KabirEsha/VariableDCSupply/photo_2025-03-07_00-40-33.jpg

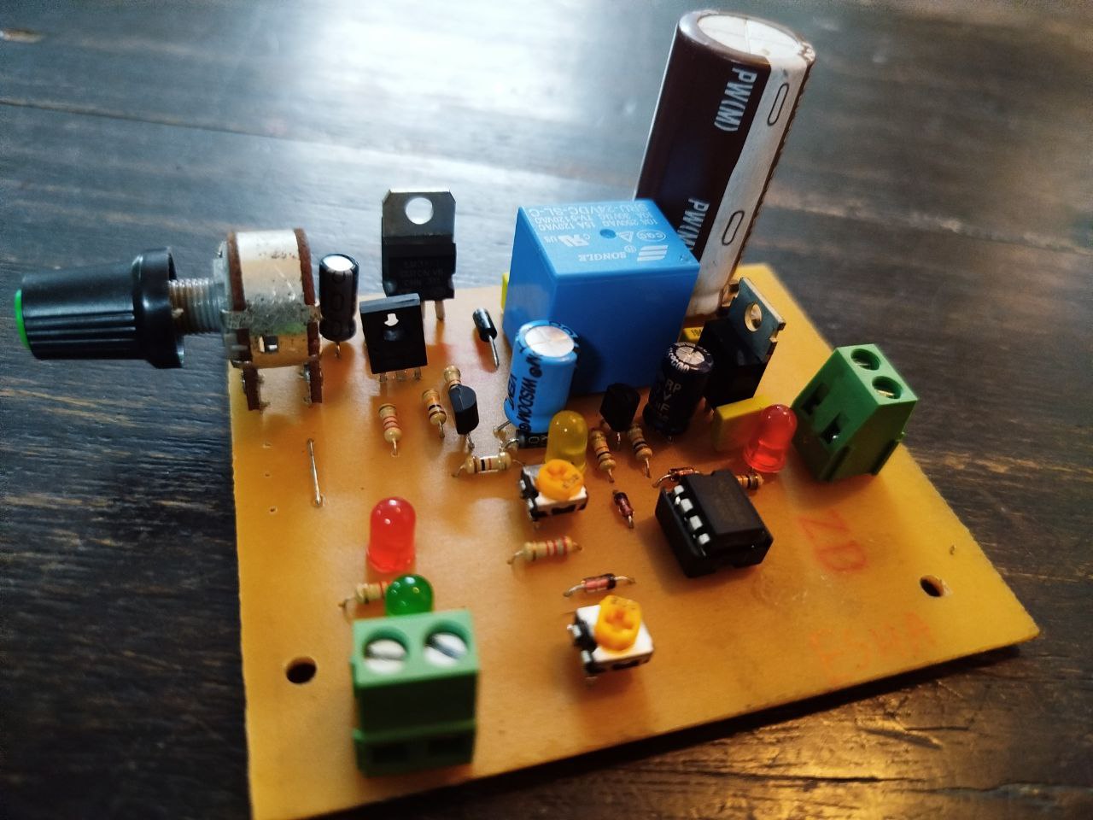
photo_2025-03-07_00-40-33.jpg
