KabirEsha/VariableDCSupply/photo_2025-03-07_00-40-39.jpg

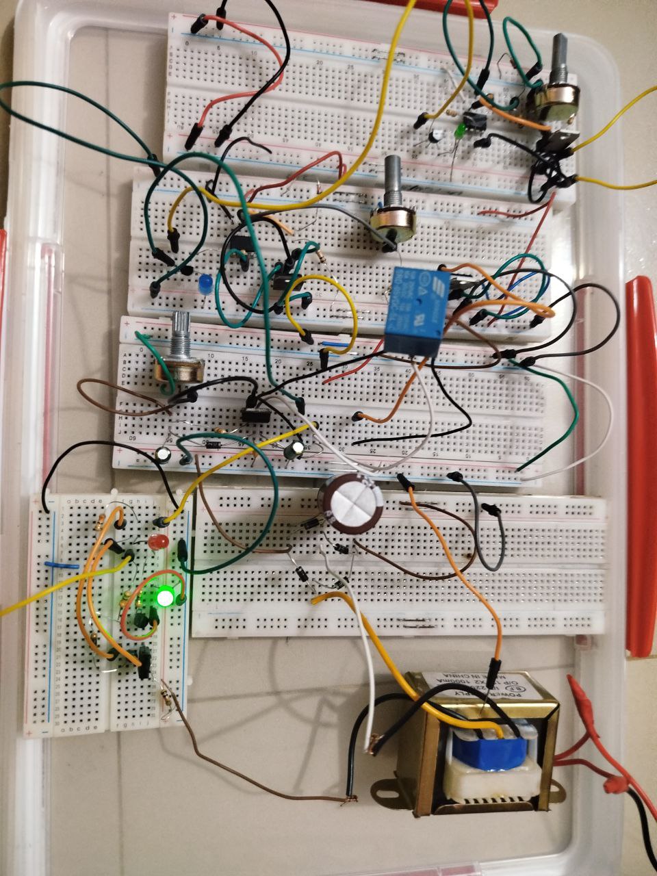
photo_2025-03-07_00-40-39.jpg
