KabirEsha/VariableDCSupply/ckt.jpg

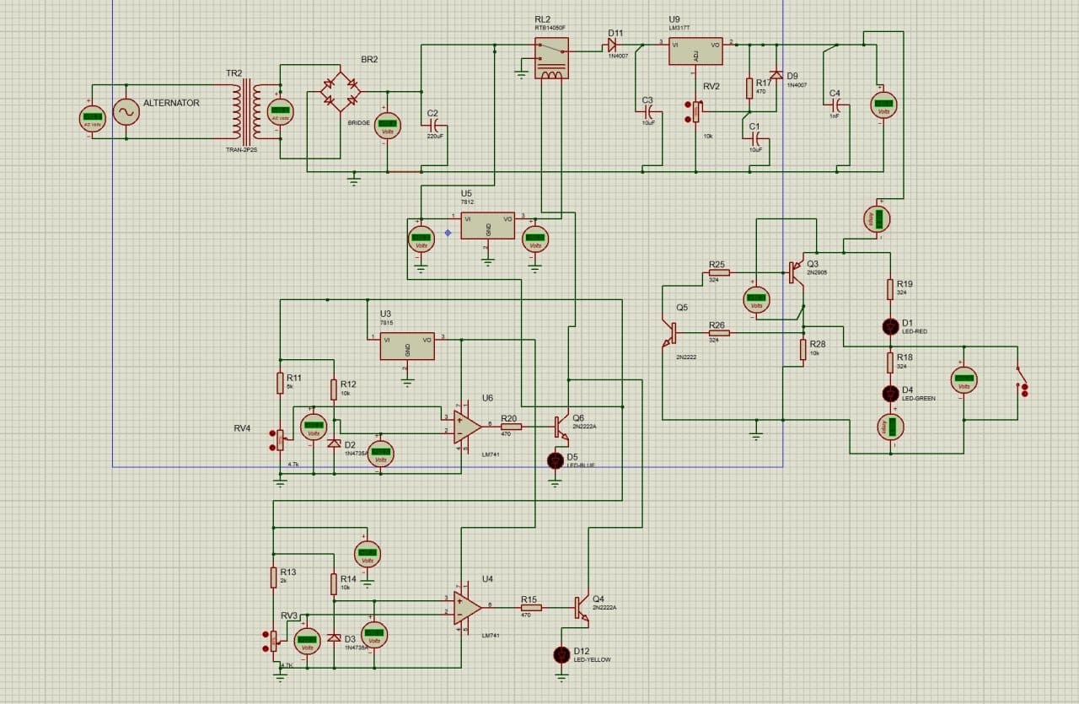
ckt.jpg
