KabirEsha/VariableDCSupply/(list of files, drawings)

Other design files:
ece2200er.pdsprj
