KabirEsha/VariableDCSupply/(commit log)

2025-03-06 dc power supply project
    [ece2200er.pdsprj]
2025-03-06 bread board & pcb
